Ayusha343/agrofilos/Images/IMG-20240322-WA0006.jpg

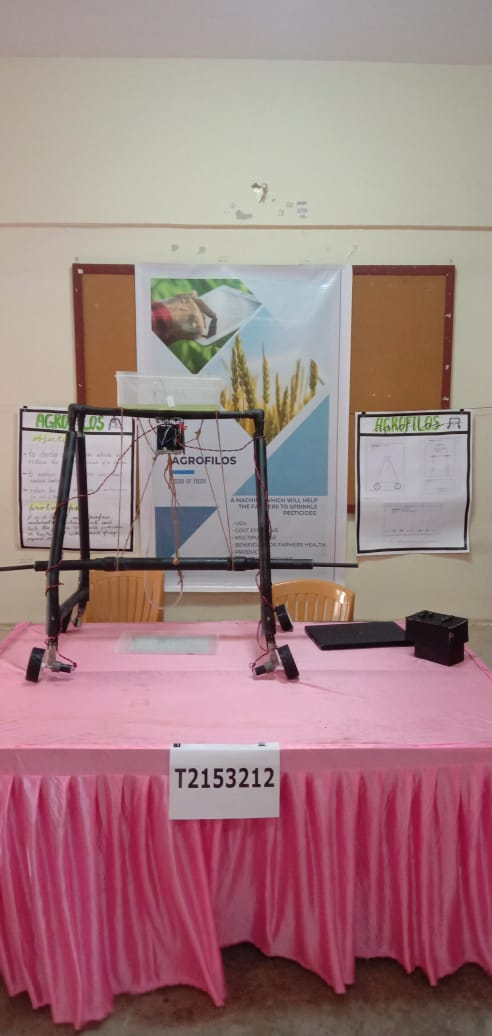
Images/IMG-20240322-WA0006.jpg
