Ayusha343/agrofilos/Blueprints/README.md

# Blueprints Folder

Contains design visuals and presentation material used during project development.

## Typical Contents

- Mechanical layout diagrams
- Structural sketches and frame dimensions
- Presentation assets for exhibitions and reviews

## Usage

When updating hardware dimensions or spray assembly layout, update this folder first and then reflect changes in `Docs/AGROFILOS_Project_Report.pdf`.
