Ayusha343/agrofilos/Docs/Repository_Map.md

# Repository Map

## Top Level

- `README.md` - project overview and entry point
- `Docs/` - report and technical documentation
- `Code/` - firmware generations and communication experiments
- `Materials/` - bill of materials and procurement references
- `Blueprints/` - drawings and slide assets
- `Patent/` - patent-related project records

## Code Tree Summary

### Current

- `Code/315Mhz RF/RadioHead/`
  - `Mains_4.0/`
  - `Transmitter_4.0/`

### Archive

- `Code/315Mhz RF/VirtualWire/`
  - dummy and v2.0 branches
  - SSD variants and alt experiments

- `Code/HC-05/`
  - Bluetooth generation (v3.0)

## Recommended Working Order

1. Read `README.md`
2. Read `Docs/AGROFILOS_Project_Report.pdf`
3. Use `Code/Firmware_Versions.md`
4. Flash from `Code/315Mhz RF/RadioHead/`
