Ayusha343/agrofilos/Patent/NOC Agrofilos.docx

No Objection Certificate by Head of the Institution

This is to certify that Aadi Mishra is a student of X - B and Ayushman Sahoo is a student of X - C of this Institution.

We certify that the innovation titled “AGROFILOS” is the original work of the applicant and is not a part of any assignment given by the School. Hence, we would recommend it for Patent filing by NRDC.

Signature: ________________________

Bipin Kumar Sahoo

D.A.V Public School, Kalinga Nagar
