Ayusha343/agrofilos/Blueprints/Dumbed Front view.png

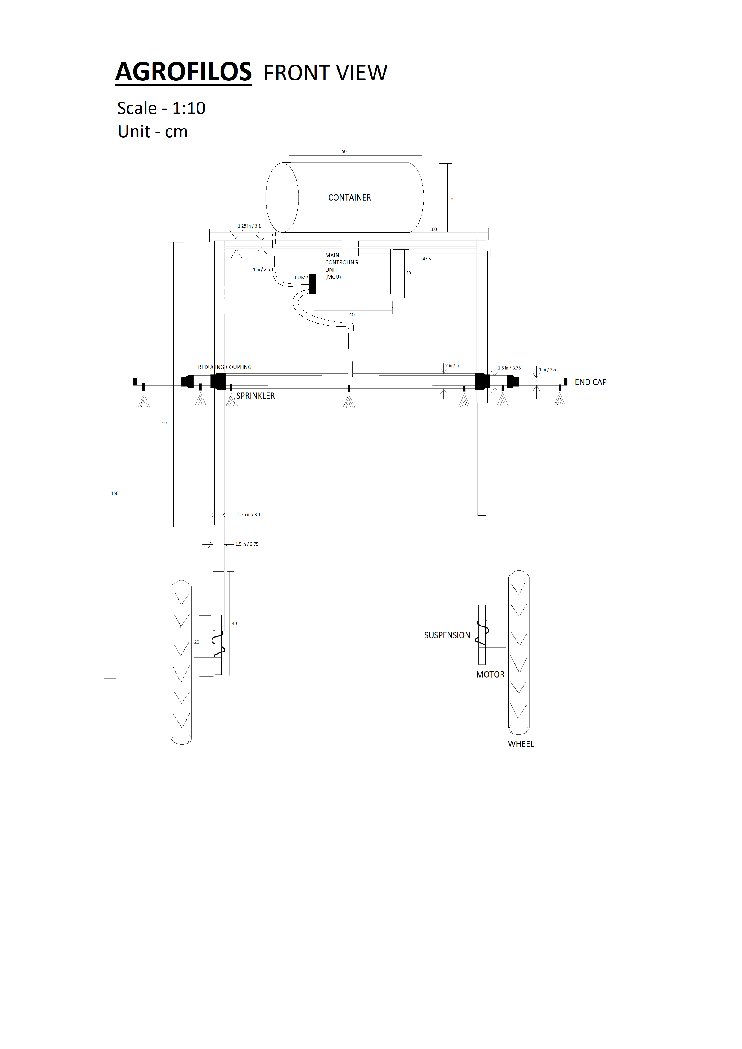
Blueprints/Dumbed Front view.png
