Ayusha343/agrofilos/Blueprints/extended top view.png

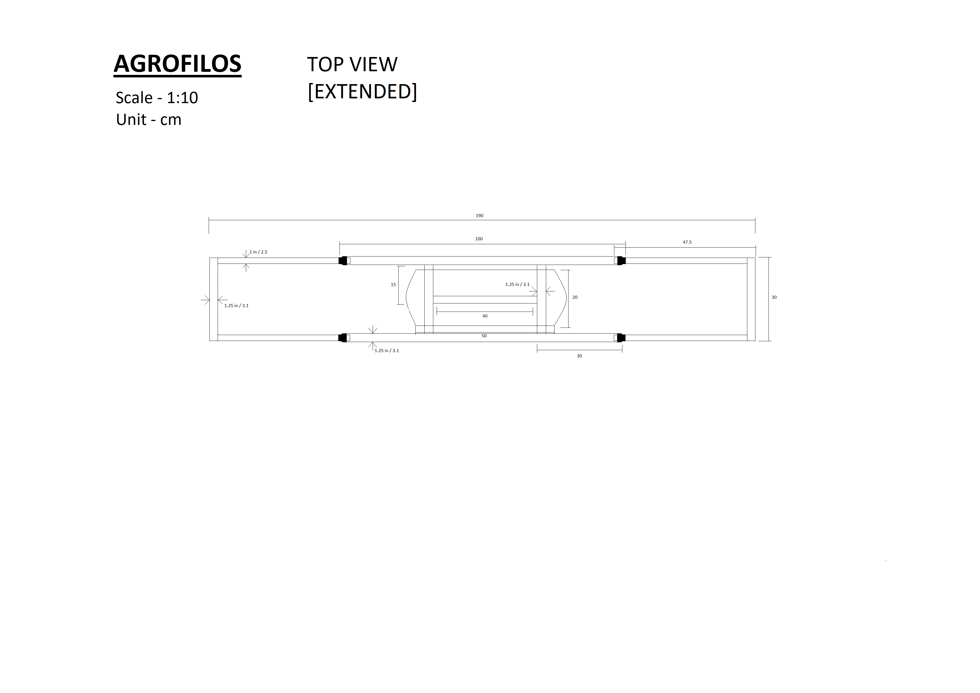
Blueprints/extended top view.png
