Ayusha343/agrofilos/Blueprints/For ppt/Main.JPG

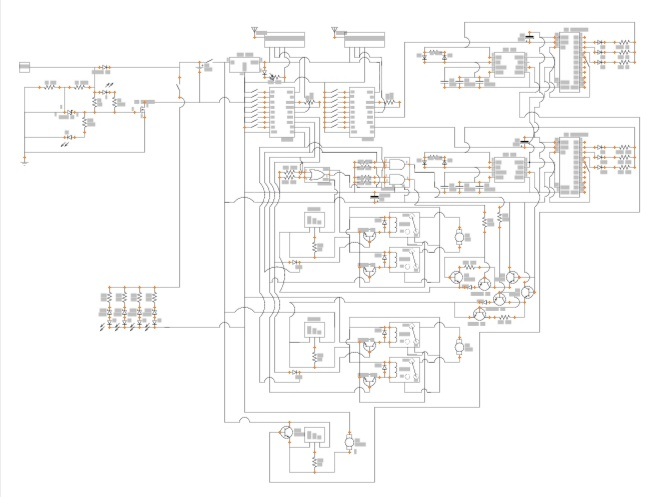
Blueprints/For ppt/Main.JPG
