Ayusha343/agrofilos/Blueprints/For ppt/Remote.JPG

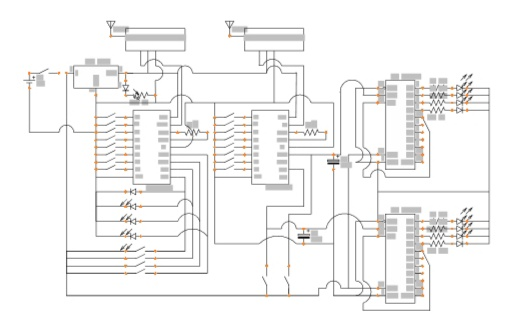
Blueprints/For ppt/Remote.JPG
