Ayusha343/agrofilos/Blueprints/For ppt/telescopic sprinkler.png

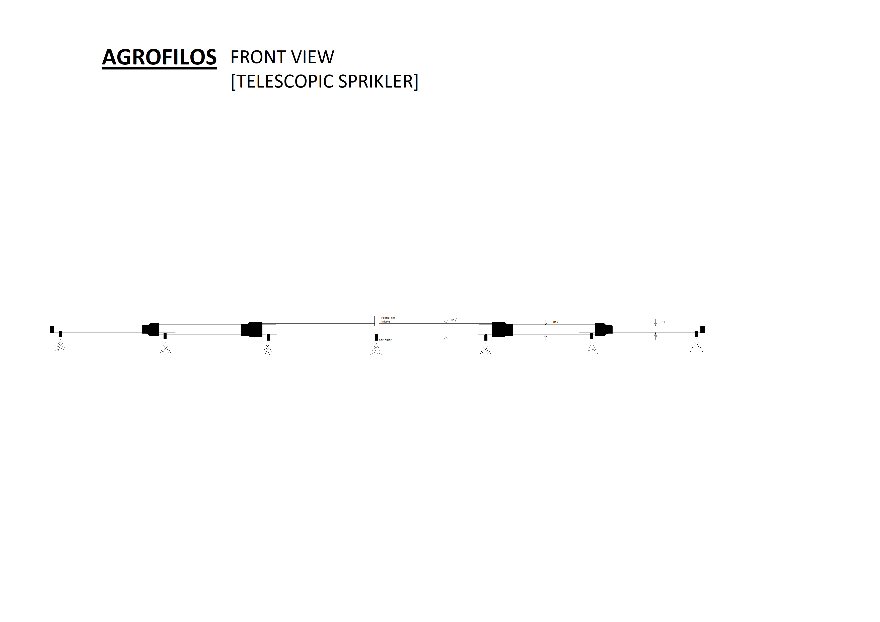
Blueprints/For ppt/telescopic sprinkler.png
