Ayusha343/agrofilos/Blueprints/Main.png

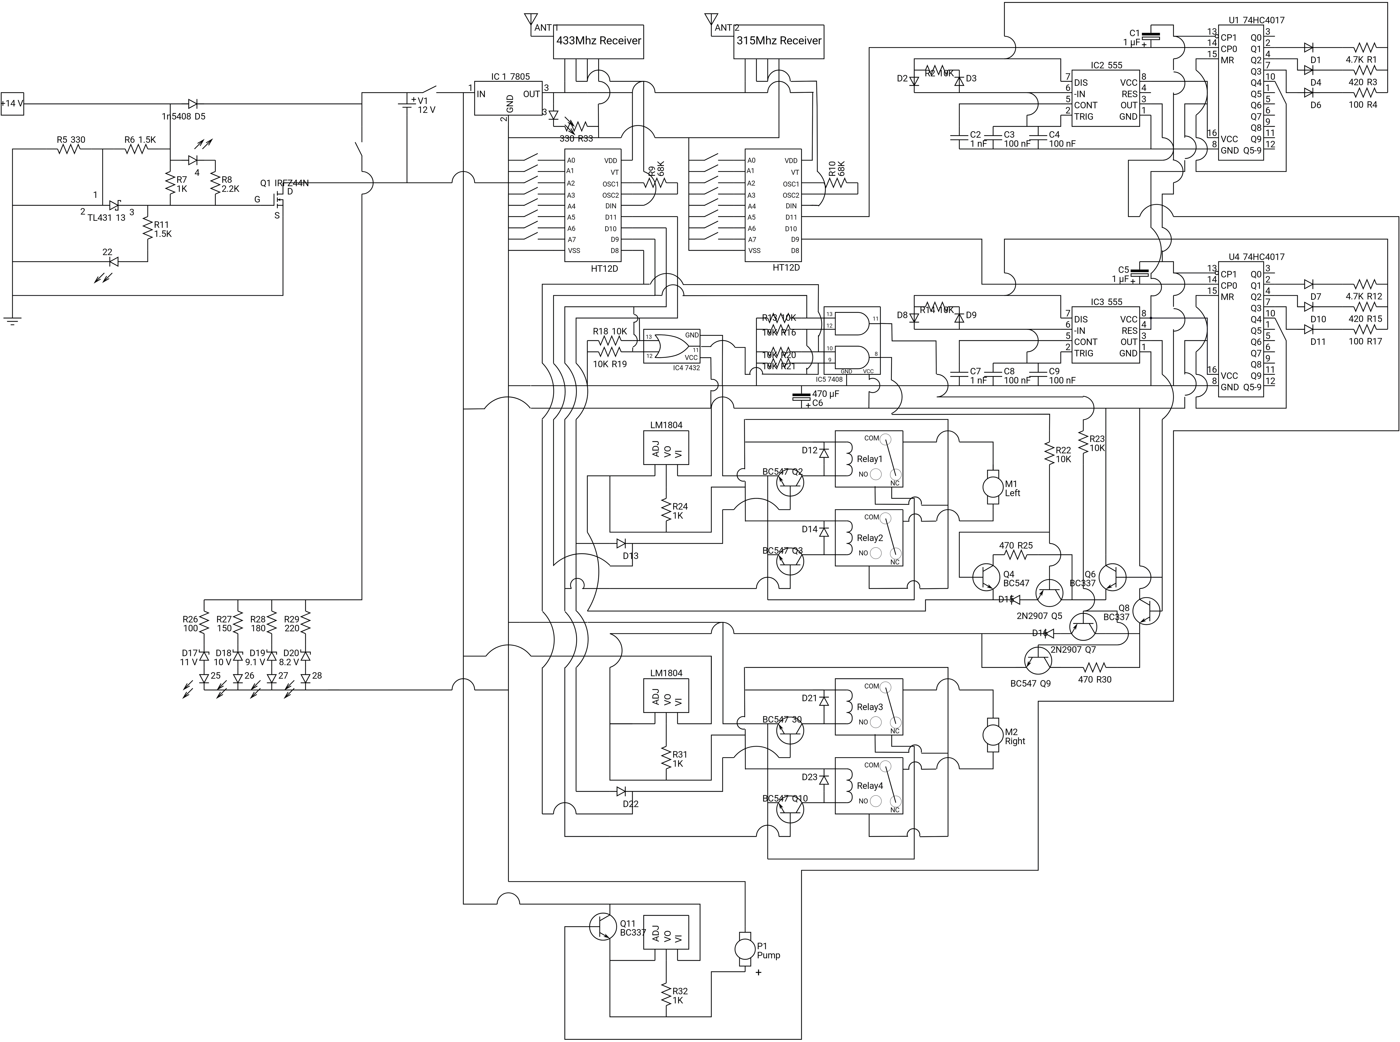
Blueprints/Main.png
