Ayusha343/agrofilos/Blueprints/Remote.png

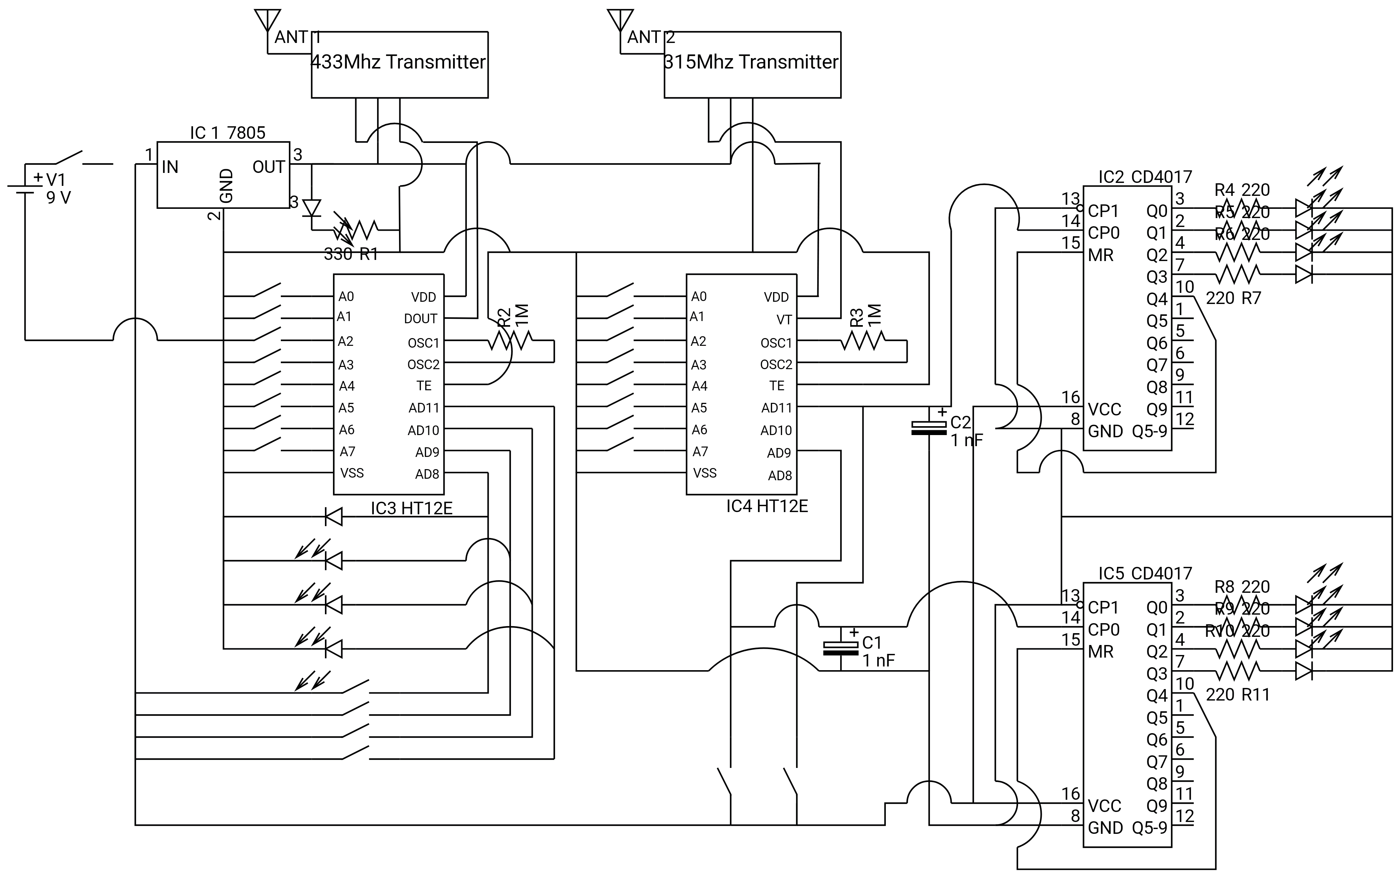
Blueprints/Remote.png
