Ayusha343/agrofilos/Blueprints/Schematic_BEEE_Sheet-1_20190503182754.png

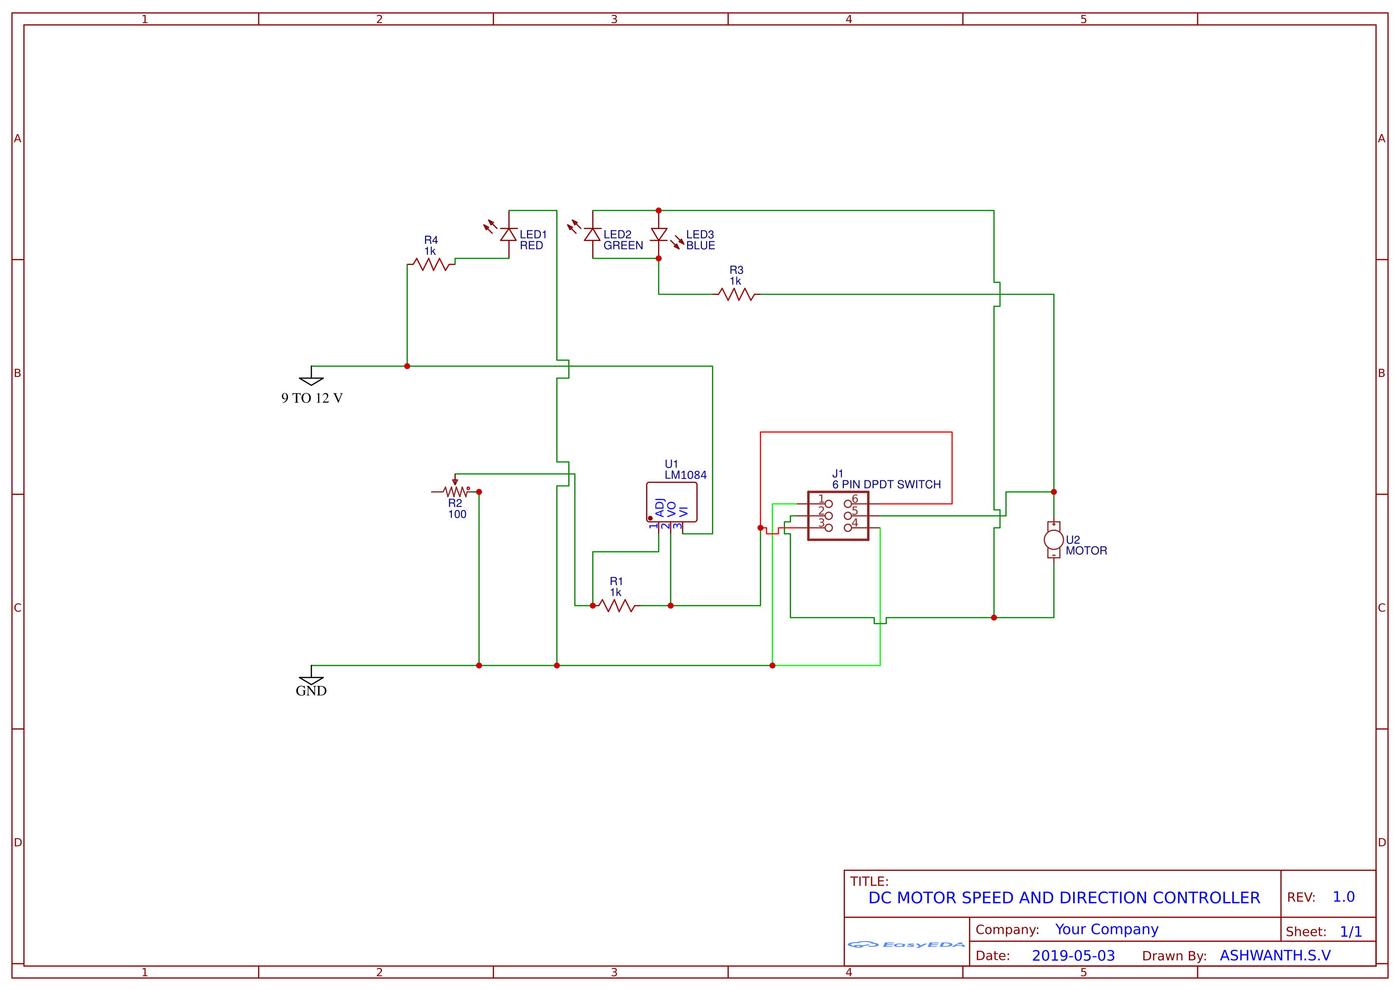
Blueprints/Schematic_BEEE_Sheet-1_20190503182754.png
