Ayusha343/agrofilos/Blueprints/Side view.png

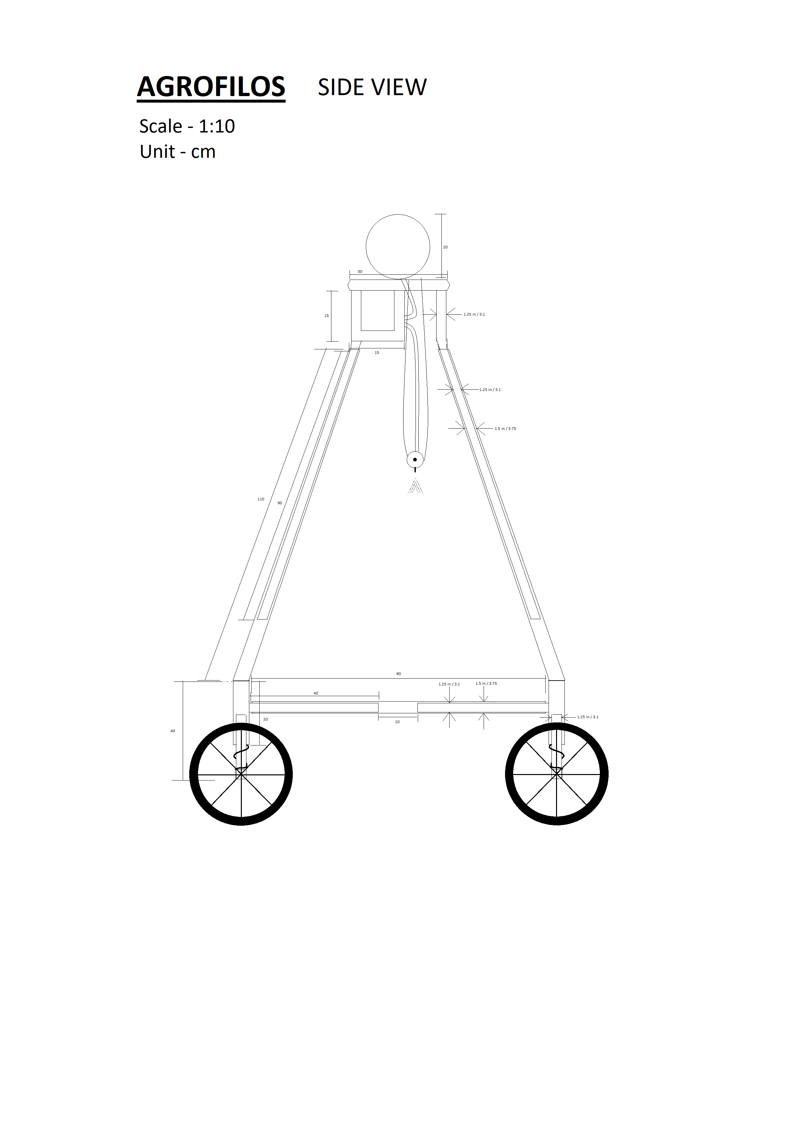
Blueprints/Side view.png
