Ayusha343/agrofilos/Blueprints/telescopic sprinkler.png

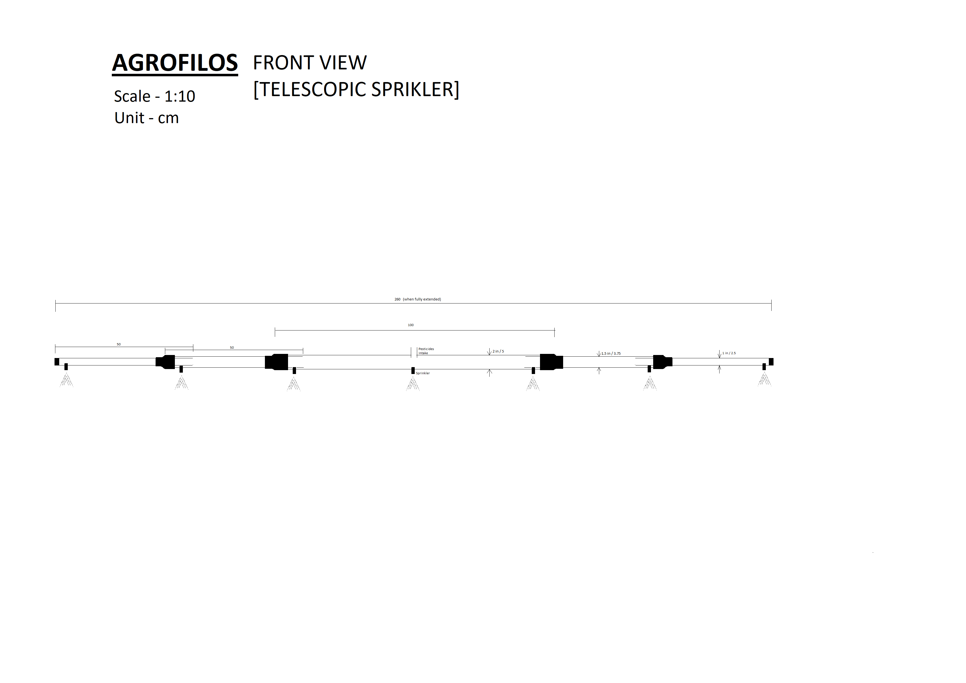
Blueprints/telescopic sprinkler.png
