Ayusha343/agrofilos/Blueprints/top view.png

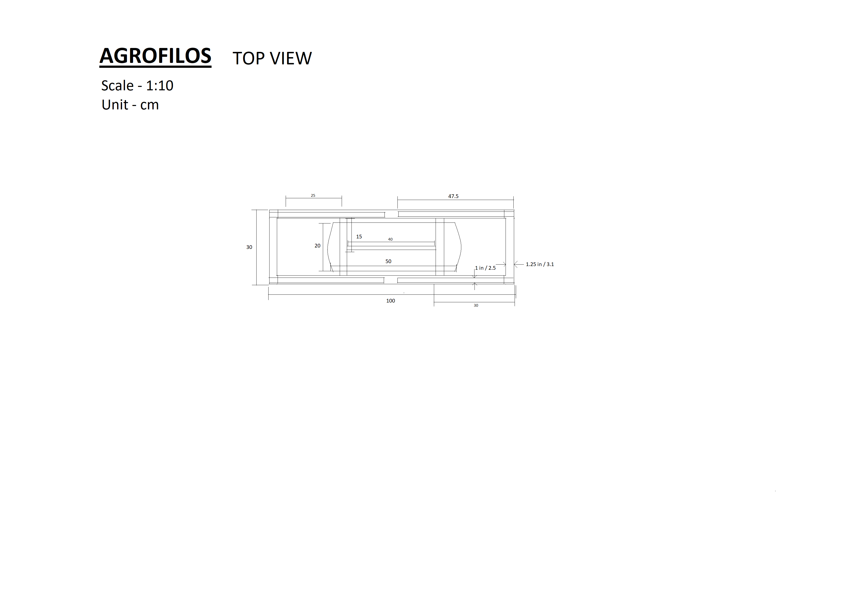
Blueprints/top view.png
