Ayusha343/agrofilos/Images/IMG-20240322-WA0007.jpg

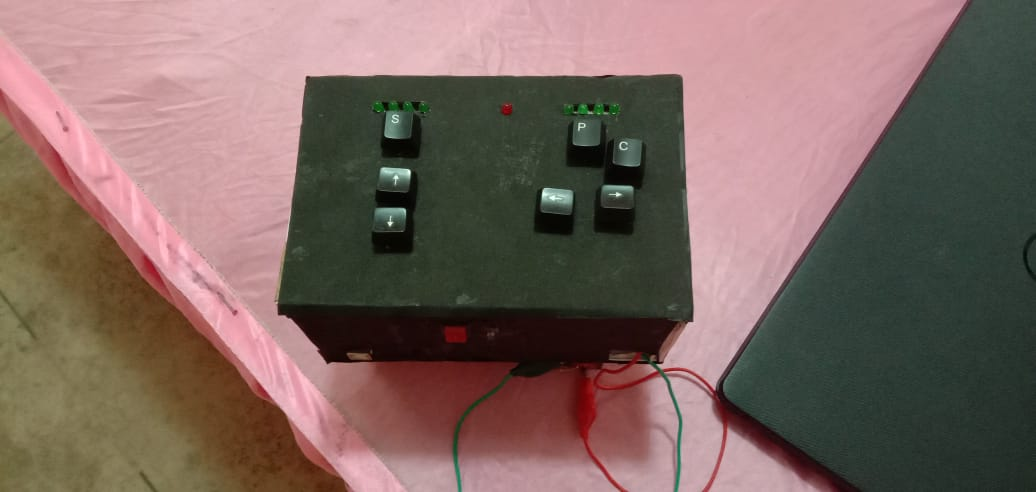
Images/IMG-20240322-WA0007.jpg
