Ayusha343/agrofilos/Materials/BILL.md

# AGROFILOS Bill Of Materials

## Scope

This file captures the structural and hardware material purchases recorded for the AGROFILOS prototype build.

## Cost Summary

- Currency: INR
- Total structural/hardware cost recorded: 4763
- Electronics and battery pricing may vary by source and purchase date

## Structural And Hardware Items

| Sl. No. | Description | Quantity | Rate | Amount | Running Total |
|---|---|---:|---:|---:|---:|
| 1 | 3/4 in cPVC male adapter | 16 | 26 | 416 | 416 |
| 2 | 3/4 in x 1/2 in cPVC female reducer | 4 | 10 | 40 | 456 |
| 3 | 3/4 in cPVC pipe (15 ft) | 1 | 27.5 | 412 | 868 |
| 4 | 1/2 in cPVC pipe (5 ft) | 1 | 18.5 | 92.5 | 960 |
| 5 | 1.5 in (40 mm) PVC pipe (13 ft 6 in) | 1 | 18 | 243 | 1203 |
| 6 | 2 in (50 mm) PVC pipe (2 ft) | 1 | 24 | 48 | 1251 |
| 7 | 1.5 in (40 mm) PVC tee | 4 | 22 | 88 | 1339 |
| 8 | 3/4 in cPVC tee | 4 | 24 | 96 | 1435 |
| 9 | 2 in x 1.5 in reducer | 2 | 20 | 40 | 1475 |
| 10 | 1/2 in cPVC end cap | 2 | 8 | 16 | 1491 |
| 11 | cPVC solvent solution | 1 | 135 | 130 | 1621 |
| 12 | Spring | 4 | 50 | 200 | 1821 |
| 13 | Sprinkler nozzle set | 1 | 150 | 150 | 1971 |
| 14 | Tube (5 ft) | 1 | 10 | 50 | 2021 |
| 15 | Gray spray paint | 1 | 300 | 300 | 2321 |
| 16 | Black spray paint | 2 | 247.5 | 495 | 2816 |
| 17 | Teflon tape | 3 | 20 | 60 | 2876 |
| 18 | GI 3/4 in 3-way elbow | 4 | 60 | 240 | 3116 |
| 19 | 4 in (110 mm) PVC pipe (3 ft 6 in) | 1 | 50 | 175 | 3291 |
| 20 | 1.5 in (40 mm) PVC pipe (17 in) | 1 | 25 | 50 | 3341 |
| 21 | 2 in (50 mm) PVC pipe (1.5 ft) | 1 | 30 | 45 | 3386 |
| 22 | 1 in uPVC pipe (6 ft) | 1 | 34 | 204 | 3590 |
| 23 | 1 in uPVC tee | 4 | 40 | 160 | 3750 |
| 24 | 1 in uPVC tee | 8 | 30 | 240 | 3990 |
| 25 | Teflon tape | 1 | 20 | 20 | 4010 |
| 26 | 5 mm GI rod (70 cm) | 1 | 9 | 20 | 4030 |
| 27 | 3 in x 10 mm bolts | 7 | 10 | 70 | 4100 |
| 28 | 3 in x 10 mm nuts | 13 | 1 | 13 | 4113 |
| 29 | 10 mm washers | 10 | 1 | 10 | 4123 |
| 30 | 1 in x 2 mm bolts | 15 | 2 | 30 | 4153 |
| 31 | 1 in x 2 mm nuts | 20 | 1 | 20 | 4203 |
| 32 | Springs | 2 | 250 | 500 | 4703 |
| 33 | Epoxy adhesive | 1 | 64 | 60 | 4763 |

## Notes

- This list focuses on frame and assembly materials.
- Electronics, motors, RF modules, and batteries should be tracked in a separate procurement log for exact budgeting.
- Keep vendor invoice copies aligned with this table when preparing grant, competition, or incubation submissions.
