Ayusha343/agrofilos/Materials/Materials.docx

MATERIALS REQUIREDS

1. Motor

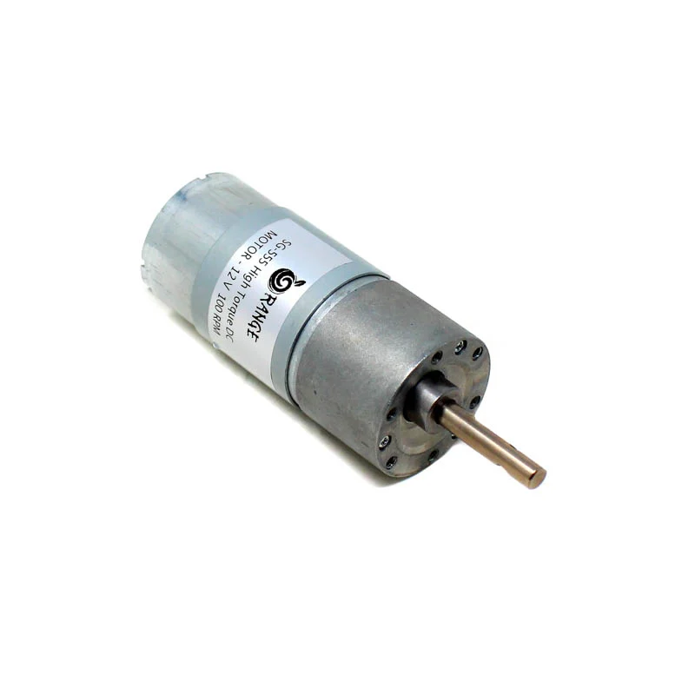
[picture p17: figure]

We need: - two 12v DC high power gearbox motors.

What we got: -https://robu.in/product/orange-12v-og555-100rpm-dc-motor-for-diy-projects-grade-a-quality/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

Features:-

Current(mA)<=4134

Torque(N.cm)= 173.6

Speed(RPM)=100

Shaft Length=27mm

Shaft Diameter=8mm

Price = 500/- x 2= 1000/-

2.Battery

We need: - 12v 7Ah battery.

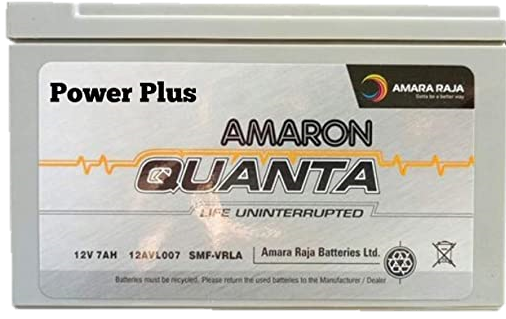
[picture p18: figure]

What we got: - https://www.amazon.in/dp/B08CVD2H13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

Features: - Voltage=12v Capacity=7Ah

Price = 1500/-

3.Pump

We need: - A 12v high power pump.

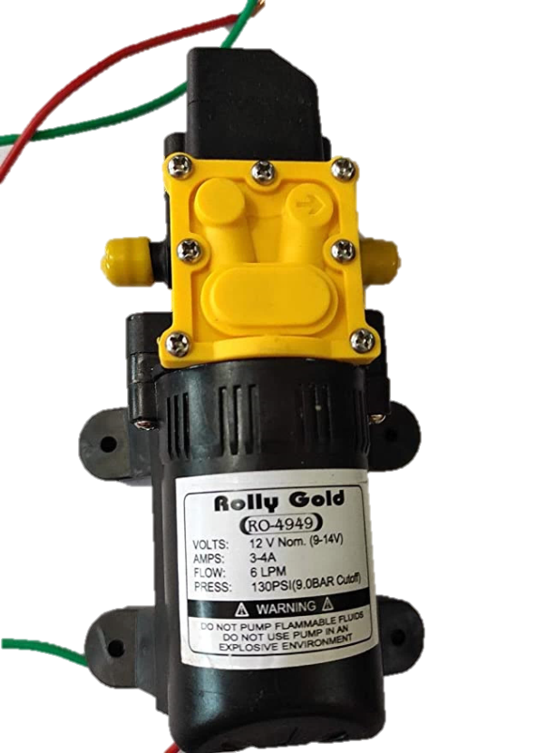
[picture p19: figure]

What we got: - https://www.amazon.in/ROLLY-GOLD-Electric-Diaphragm-Pressure/dp/B07ZM2NXPY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

Features: -

Pressure = 130PSI

Flow = 6 litres/min

Voltage = 12v

Current = 3-4 A

Price = 500/-

4. Nozzeles

What we need: - Few high-pressure nozzles capable of spraying pesticides like actual product.

What we got: - https://www.amazon.in/Generic-Adjustable-Sprayer-Watering-Irrigation/dp/B019C58XSY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

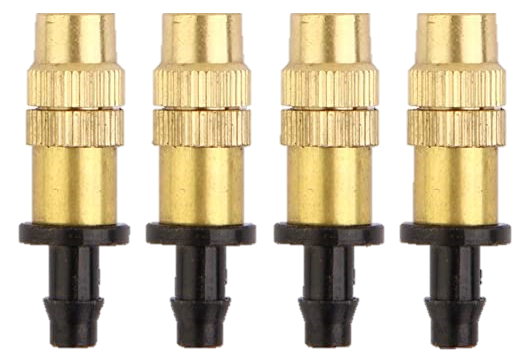
[picture p20: figure]

Features: -

Metal = Brass 8cm x 5cm x 1cm

Price = 375/- × 2 = 750

5. The motor controler

What we need: - A circuit which can control speed and direction of the motors.

What we got: -

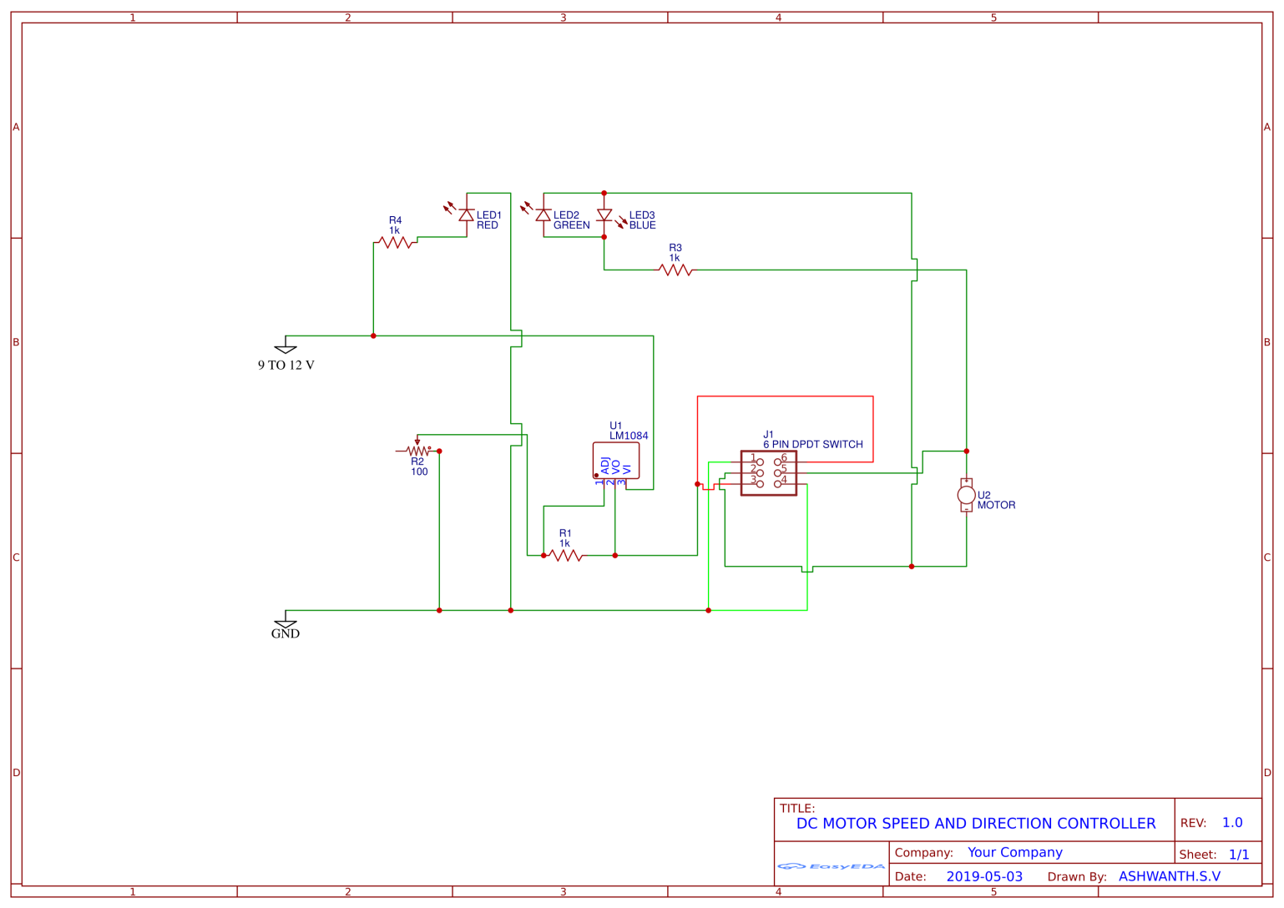
[picture p21: figure]

LM1084: LM1084IT-5.0/NOPB Texas Instruments | Integrated Circuits (ICs) | DigiKey (https://www.digikey.in/en/products/detail/texas-instruments/LM1084IT-5-0-NOPB/363556)

250/- × 2 – 500/-

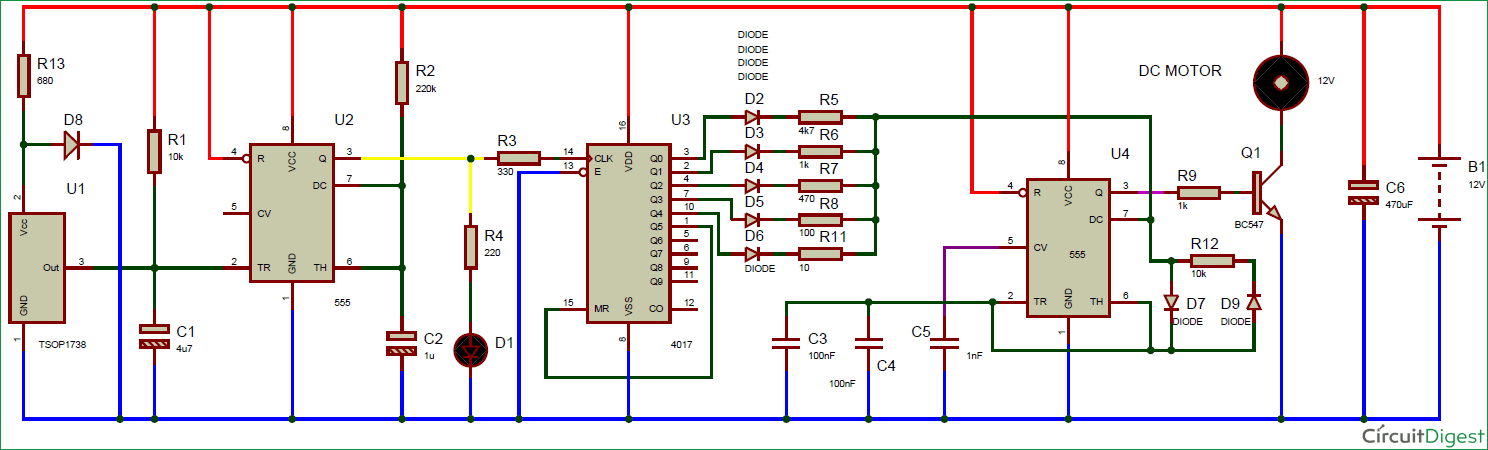
[picture p22: figure]

The above circuit is for controlling speed of only motor, can be duplicated for the pump.

6. The signal transmitter and receiver

What we need: - A circuit which can transmit and receive signals for motor speed, pump pressure and control directions.

What we got: - Buy 433MHz 100 meter STX882 ASK Transmitter w/ SRX882 Receiver (robu.in) (https://robu.in/product/433mhz-100-meters-stx882-ask-transmitter-module-srx882-superheterodyne-receiver-module-antenna/)

220/- × 2 – 440/-

(1) How to make simple wireless using RF module : Tutorial 28 - YouTube (https://www.youtube.com/watch?v=wE9LY20xEf0)

Tutorial (https://www.instructables.com/RF-433MHZ-Radio-Control-Using-HT12D-HT12E-Making-a/)

7. BMS

What we need: - A circuit which can show battery levels, charge the battery and auto cut off when done.

What we got: -

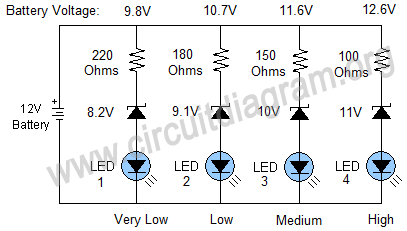
[picture p23: figure]

Auto cut off - Tutorial (https://www.youtube.com/watch?v=xNgKgI7SC3k&ab_channel=CreativeTechos)

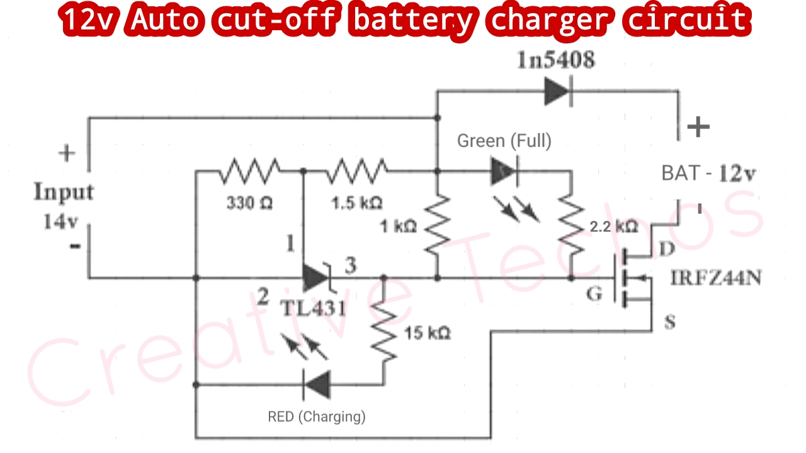
[picture p24: figure]

220v AC to 14v DC 2 A -

8. The main circuit

What we need: - A circuit which can receive signals, control speed and direction of the motors and pressure of pump.

What we got: -

Other small components like wire, capacitors, LEDs, switches etc. will cost less than 100/-.

Expected Expenditures

SL | Name | Price | Quantity | Total
1. | Motor | 500 | 2 | 1000
2. | Pump | 500 | 1 | 500
3. | Battery | 1500 | 1 | 1500
4. | Motor Driver Module | 615 | 1 | 615
5. | Nozzles | 375 | 10 | 750
6.
7.
8.
9.
10.
11. | Others | 200 | Many | 200
TOTAL
