Ayusha343/agrofilos/Materials/my name is BILL.xlsx

AGROFILOS
SL. No. | Description | Qnty. | Rate | Amount | Total
1 | 3/4" cPVC male adapter | 16 | 26 | 416 | 416
2 | 3/4" x 1/2" cPVC female reducer | 4 | 10 | 40 | 456
3 | 3/4" cPVC pipe | 15' | 27.5 | 412 | 868
4 | 1/2" cPVC pipe | 5' | 18.5 | 92.5 | 960
5 | 1.5" (40mm) PVC pipe | 13' 6" | 18 | 243 | 1203
6 | 2" (50mm) PVC pipe | 2' | 24 | 48 | 1251
7 | 1.5" (40mm) PVC Tee | 4 | 22 | 88 | 1339
8 | 3/4" cPVC Tee | 4 | 24 | 96 | 1435
9 | 2" x 1.5" (50mm x 40mm) reducer | 2 | 20 | 40 | 1475
10 | 1/2" cPVC end cap | 2 | 8 | 16 | 1491
11 | cPVC solvent solution | 1 | 135 | 130 | 1621
12 | Spring | 4 | 50 | 200 | 1821
13 | Sprinkler nozzle | 1 | 150 | 150 | 1971
14 | Tube | 5' | 10 | 50 | 2021
15 | Gray Spray paint | 1 | 300 | 300 | 2321
16 | Black Spray paint | 2 | 247.5 | 495 | 2816
17 | Teflon tape | 3 | 20 | 60 | 2876
18 | GI 3/4" 3 way elbow | 4 | 60 | 240 | 3116
19 | 4" (110mm) PVC pipe | 3' 6" | 50 | 175 | 3291
20 | 1.5" (40mm) PVC pipe | 17" | 25 | 50 | 3341
21 | 2" (50mm) PVC pipe | 1.5' | 30 | 45 | 3386
22 | 1" uPVC pipe | 6' | 34 | 204 | 3590
23 | 1" uPVC Tee | 4 | 40 | 160 | 3750
24 | 1" uPVC Tee | 8 | 30 | 240 | 3990
24 | Teflon tape | 1 | 20 | 20 | 4010
25 | 5 mm GI rod | 70 cm | 9 | 20 | 4030
26 | 3 inch x 10 mm Bolts | 7 | 10 | 70 | 4100
27 | 3 inch x 10 mm Nuts | 13 | 1 | 13 | 4113
28 | 10 mm Warshers | 10 | 1 | 10 | 4123
29 | 1 inch x 2 mm Bolts | 15 | 2 | 30 | 4153
30 | 1 inch x 2 mm Nuts | 20 | 1 | 20 | 4203
31 | Springs | 2 | 250 | 500 | 4703
32 | Epoxy adhesive | 1 | 64 | 60 | 4763
