Ayusha343/agrofilos/Blueprints/Trash/pvc materials 1.png

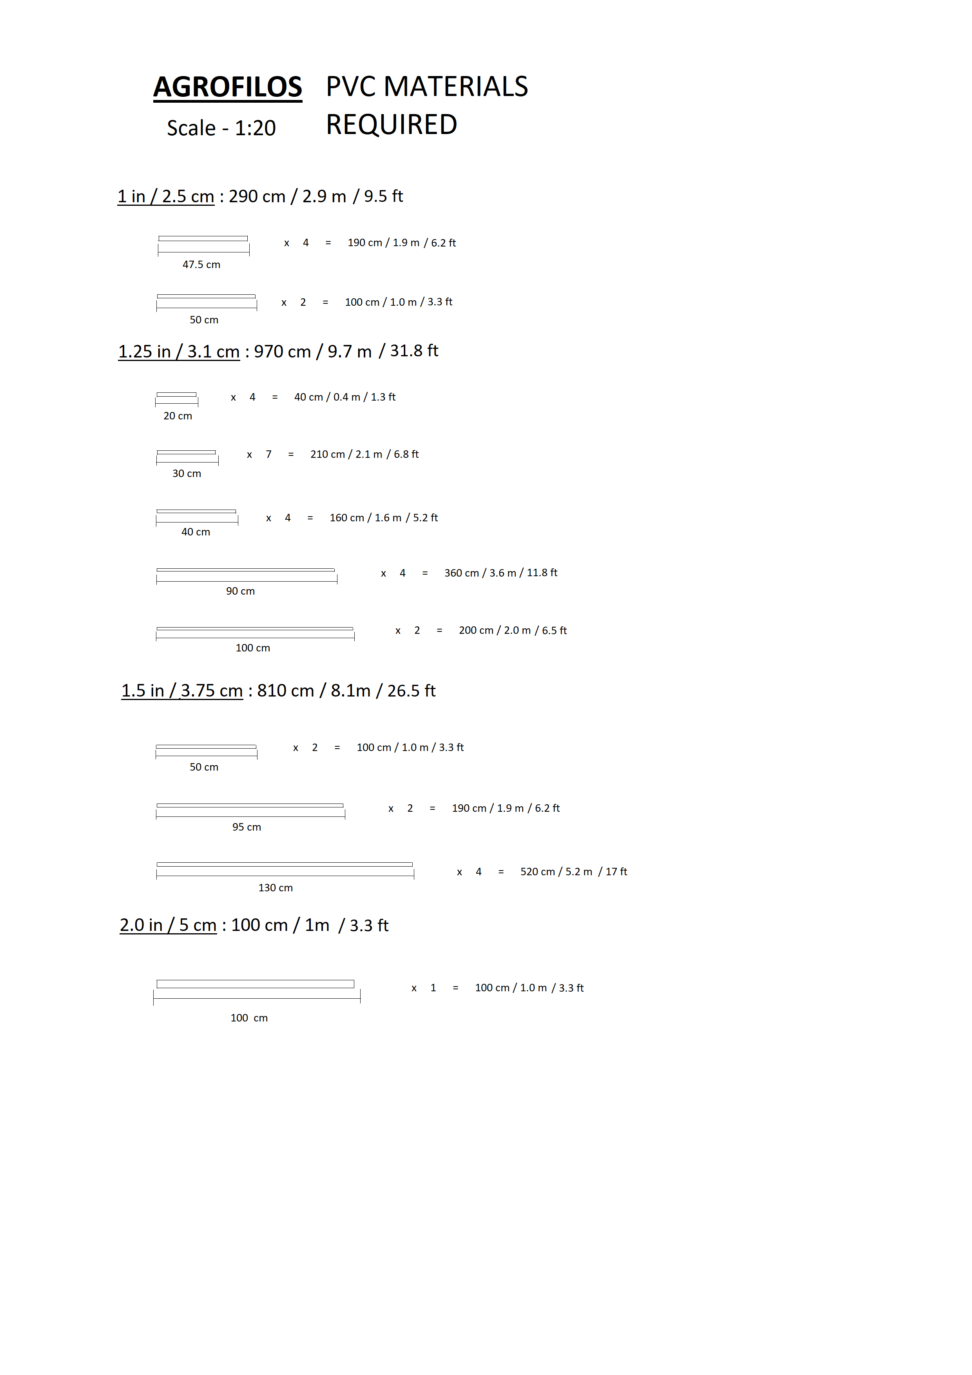
Blueprints/Trash/pvc materials 1.png
