Ayusha343/agrofilos/Blueprints/Trash/pvc materials.png

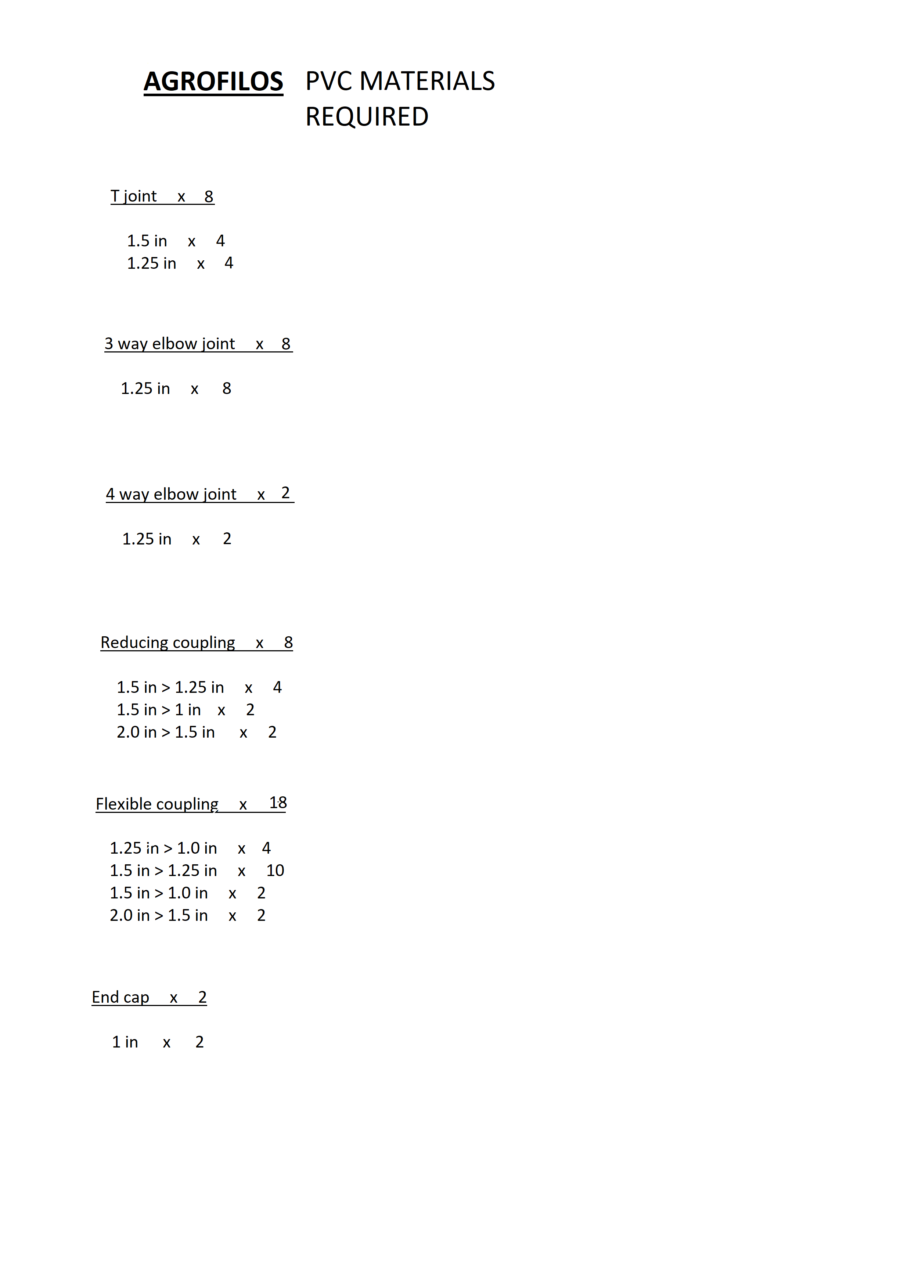
Blueprints/Trash/pvc materials.png
